mjakuipers/MLDL2000-Hardware/Schematics/CPDL_Mem.pdf

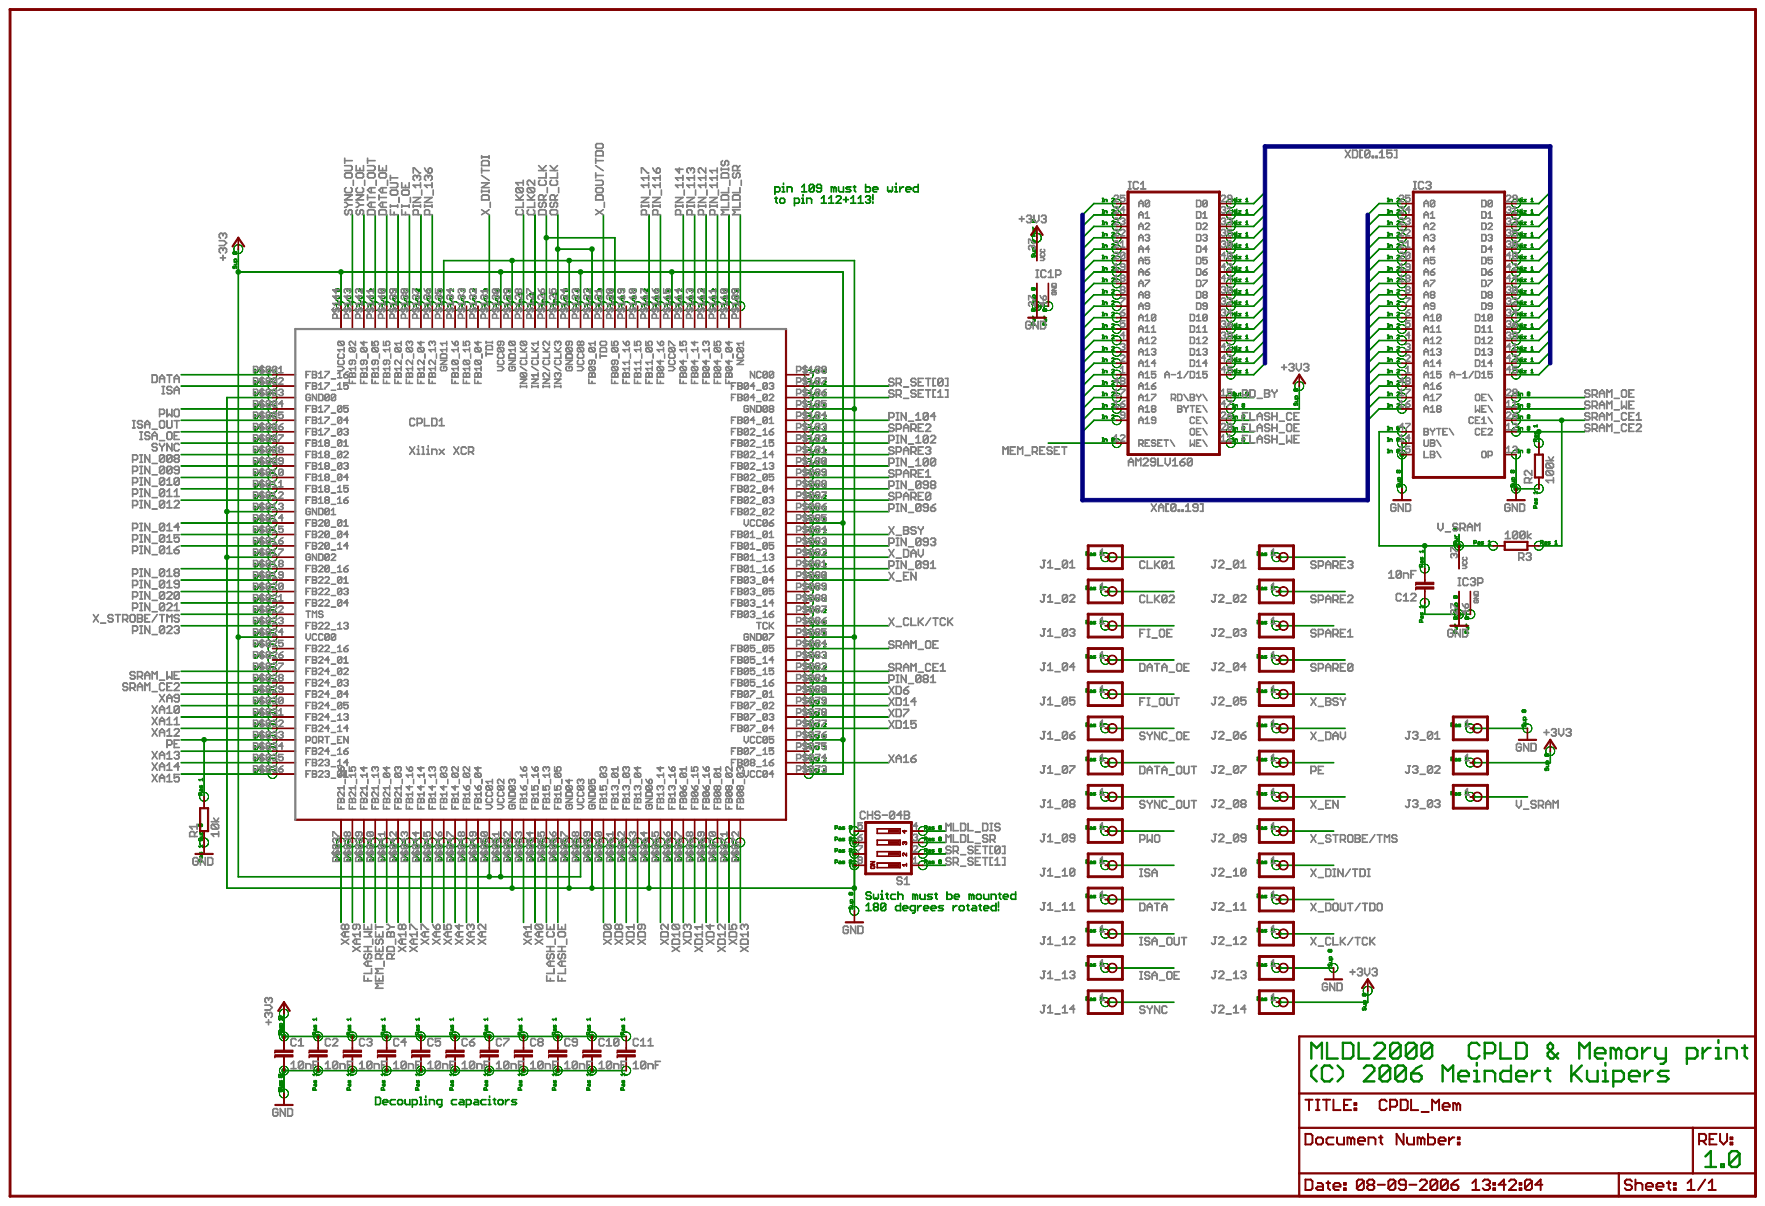
[picture p38: page 1]
