mjakuipers/MLDL2000-Hardware/Schematics/IF_Power.pdf

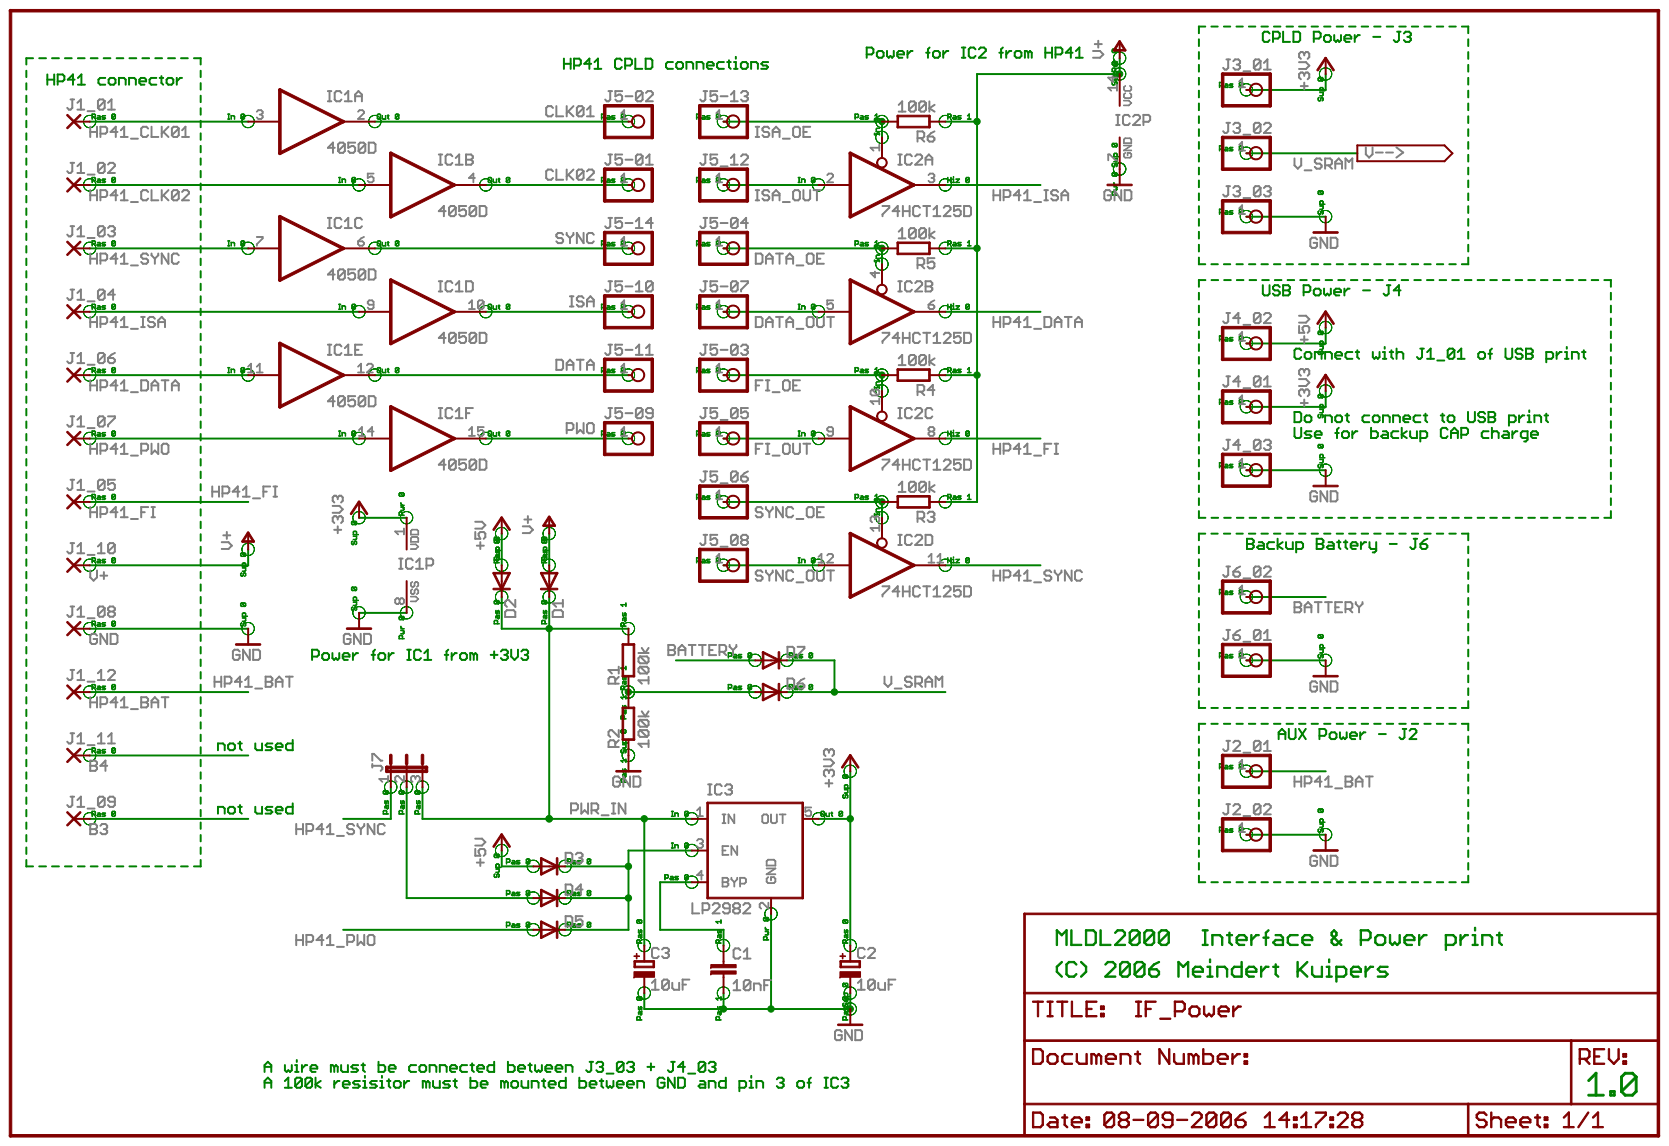
[picture p39: page 1]
