mjakuipers/MLDL2000-Hardware/Schematics/USB_IF.pdf

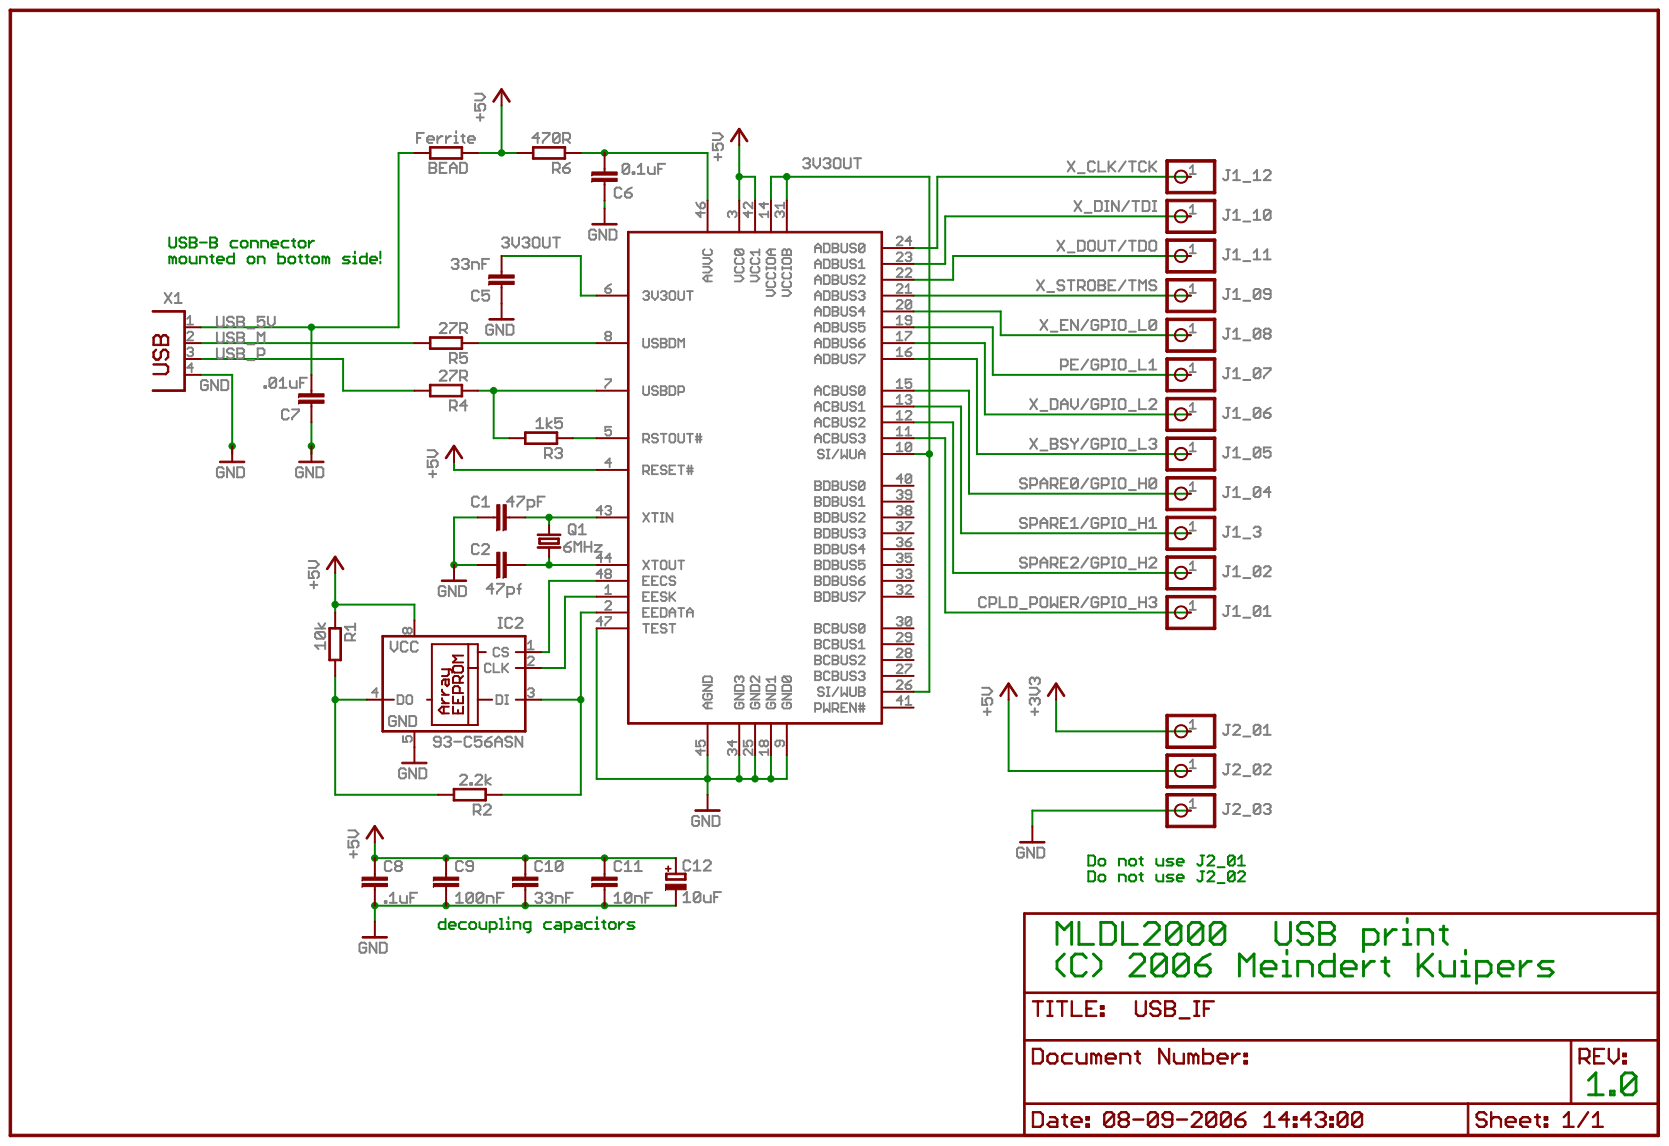
[picture p40: page 1]
